clowrey/CellKeeper-BMS-PCB/enclosure/output/preview_kicad_bottom.png

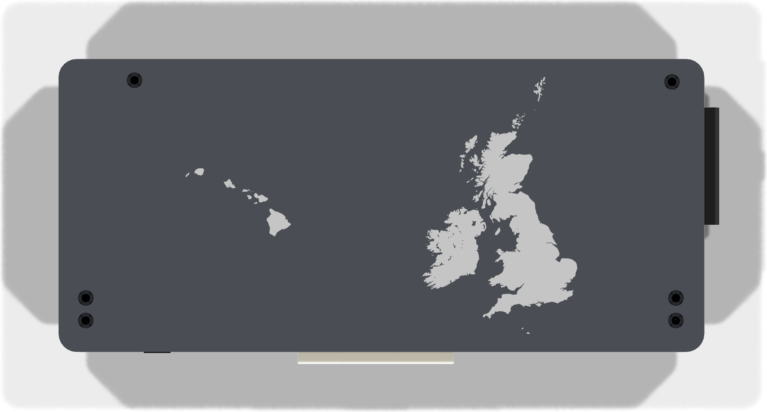
enclosure/output/preview_kicad_bottom.png
