clowrey/CellKeeper-BMS-PCB/enclosure/output/preview_kicad_top.png

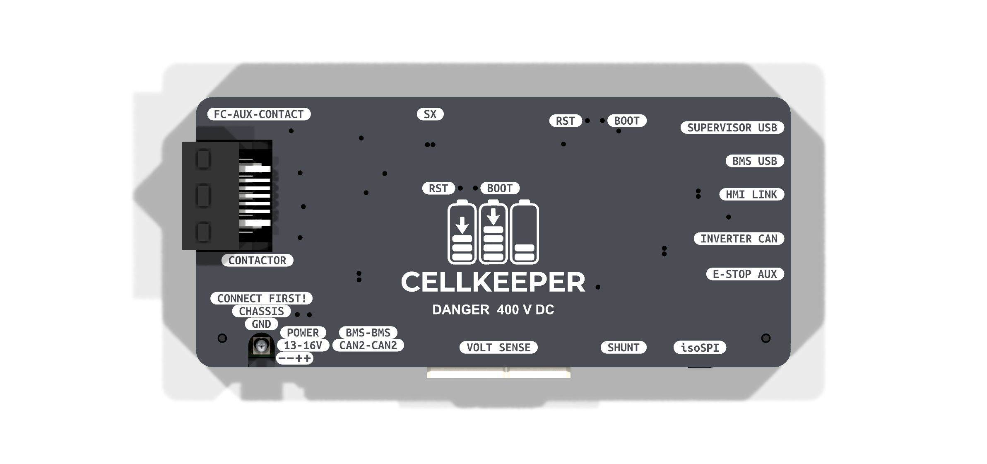
enclosure/output/preview_kicad_top.png
