clowrey/CellKeeper-BMS-PCB/enclosure/output/kicad/case_base.step

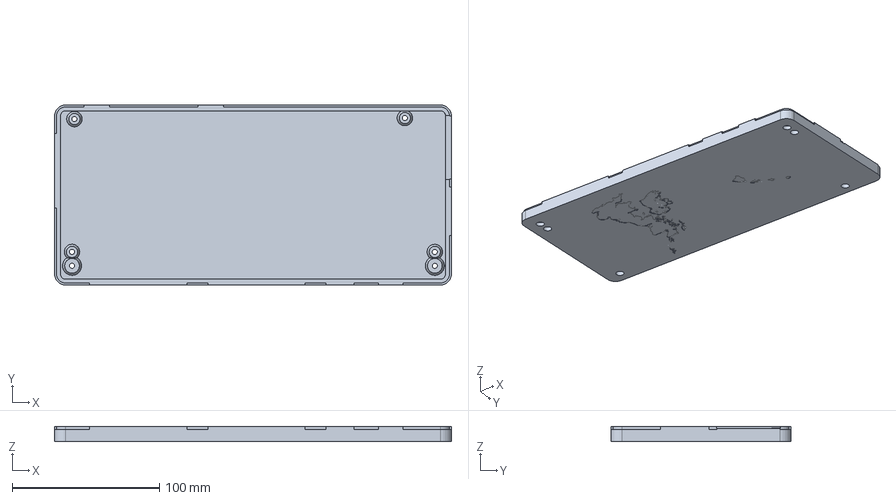
[picture p5: CAD file, 2026-10-24]
enclosure/output/kicad/case_base.step
269.2 x 122.2 x 10.0 mm
