clowrey/CellKeeper-BMS-PCB/enclosure/output/print/split/split_lid_right_2color_inlay.stl

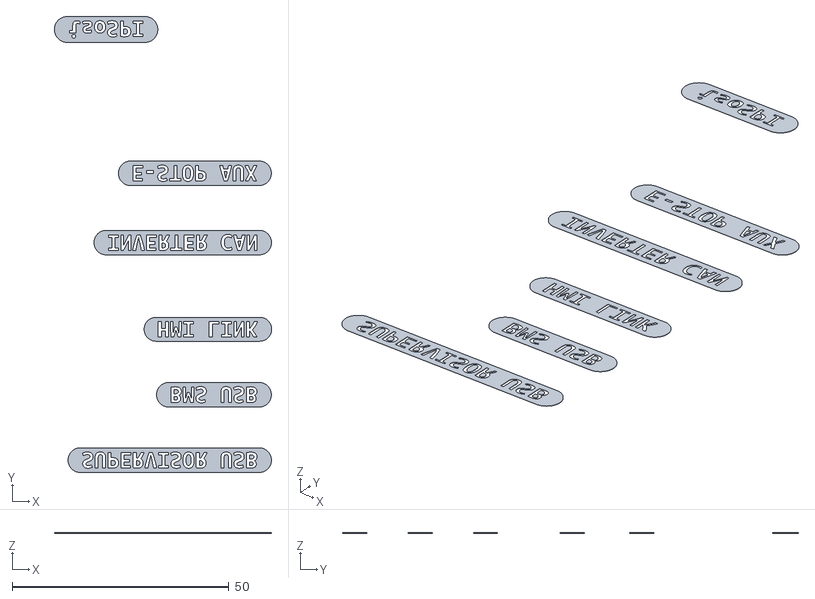
[picture p6: CAD file, 2026-10-24]
enclosure/output/print/split/split_lid_right_2color_inlay.stl
50.2 x 105.3 x 0.2
