clowrey/CellKeeper-BMS-PCB/enclosure/output/kicad/case_lid.step

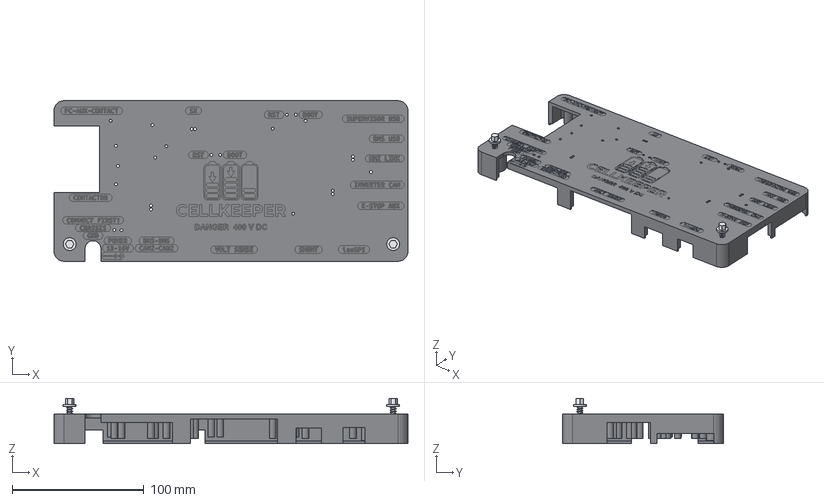
[picture p7: CAD file, 2026-10-24]
enclosure/output/kicad/case_lid.step
269.2 x 122.2 x 34.5 mm
case_lid
bracket_screw x 2
