clowrey/CellKeeper-BMS-PCB/enclosure/output/print/base.step

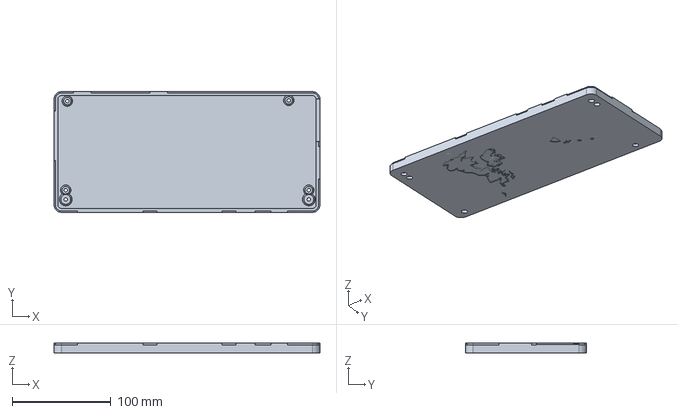
[picture p8: CAD file, 2026-10-24]
enclosure/output/print/base.step
269.2 x 122.2 x 10.0 mm
