clowrey/CellKeeper-BMS-PCB/enclosure/output/CellKeeper_board.step

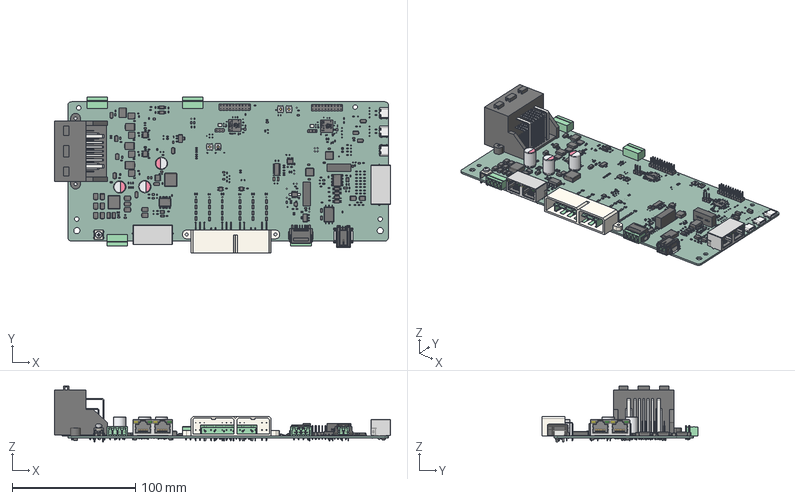
[picture p9: CAD file, 2026-10-21]
enclosure/output/CellKeeper_board.step
272.4 x 126.4 x 45.4 mm
D_SMB x 13
C_0603_1608Metric x 46
R_0603_1608Metric x 122
TSSOP-10_3x3mm_P0.5mm x 3
LED_0805_2012Metric x 21
R_1206_3216Metric x 28
C_0805_2012Metric x 18
R_0402_1005Metric x 24
PinHeader_1x03_P254mm_Vertical x 2
SOP-4_4.4x2.6mm_P1.27mm x 6
C_0402_1005Metric x 36
USB-C_SMD-TYPE-C-31-M-12 x 3
SOP-8_6.605x9.655mm_P2.54mm x 2
E5J88-44AHS4-LT x 2
D_SMA x 12
SOT-223 x 2
HTSOP_8_1EP_39x49mm_Pitch127mm
PinHeader_2x10_P254mm_Vertical x 2
L_Changjiang_FXL1040 x 2
a4dc038a-92ba-11ed-bd60-83025610b399_part x 4
a4dc038b-92ba-11ed-bd60-83025610b399_part x 4
a4dc038c-92ba-11ed-bd60-83025610b399_part x 4
a4dc038d-92ba-11ed-bd60-83025610b399_part x 4
SOIC-8_3.9x4.9mm_P1.27mm x 4
MC_01x04_G_3_81mm x 4
L_0603_1608Metric x 3
C_1206_3216Metric x 2
SOIC-16_3.9x9.9mm_P1.27mm
GMSTBA_01x06_G_7_62mm
Crystal_SMD_3225-4Pin_3.2x2.5mm x 2
D_SMC x 4
MC_01x02_G_3_81mm
L_Changjiang_FXL0630 x 2
MC_01x08_G_3_81mm
CellKeeper_PCB
