clowrey/CellKeeper-BMS-PCB/enclosure/output/kicad/case_inlay.step

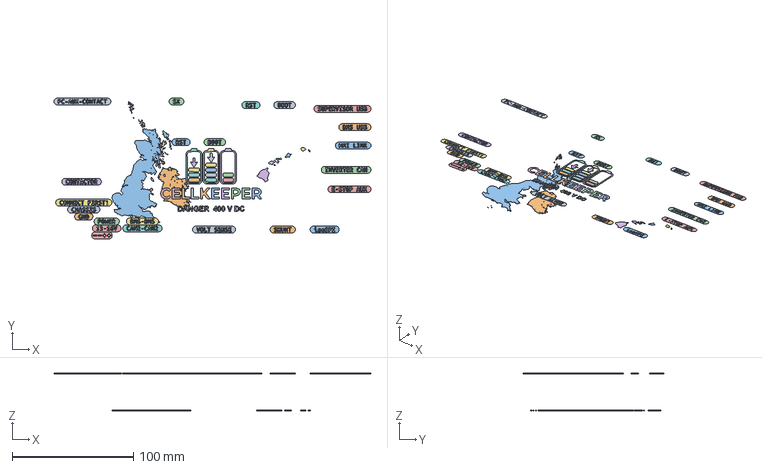
[picture p10: CAD file, 2026-10-24]
enclosure/output/kicad/case_inlay.step
261.1 x 116.1 x 30.6 mm
