clowrey/CellKeeper-BMS-PCB/enclosure/output/print/lid_2color.step

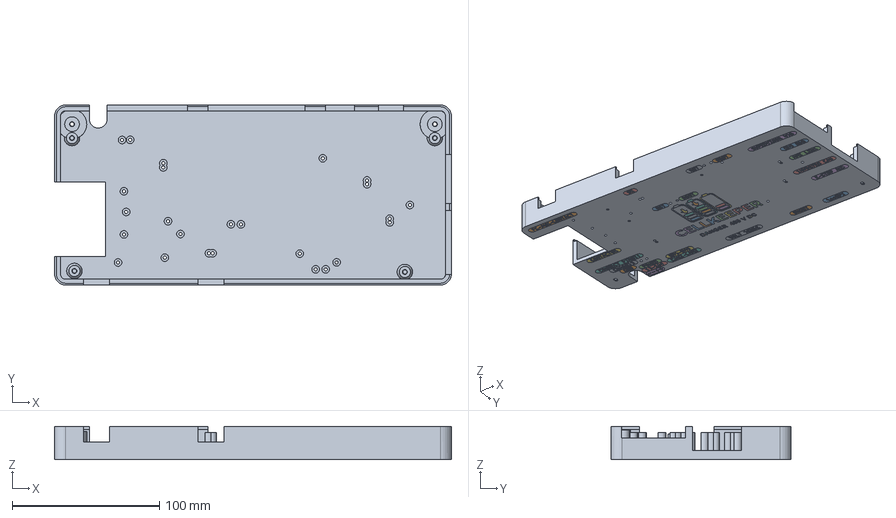
[picture p11: CAD file, 2026-10-24]
enclosure/output/print/lid_2color.step
269.2 x 122.2 x 22.4 mm
case
inlay
