clowrey/CellKeeper-BMS-PCB/enclosure/output/print/split/split_base_right_2color.step

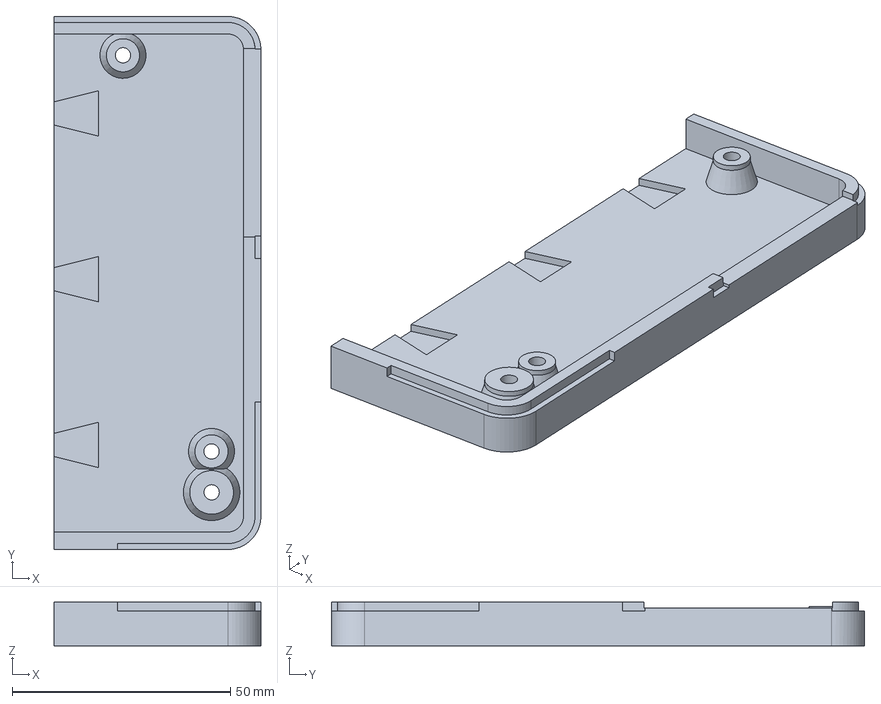
[picture p12: CAD file, 2026-10-24]
enclosure/output/print/split/split_base_right_2color.step
47.4 x 122.2 x 10.0 mm
