clowrey/CellKeeper-BMS-PCB/enclosure/output/enclosure_bambu.3mf

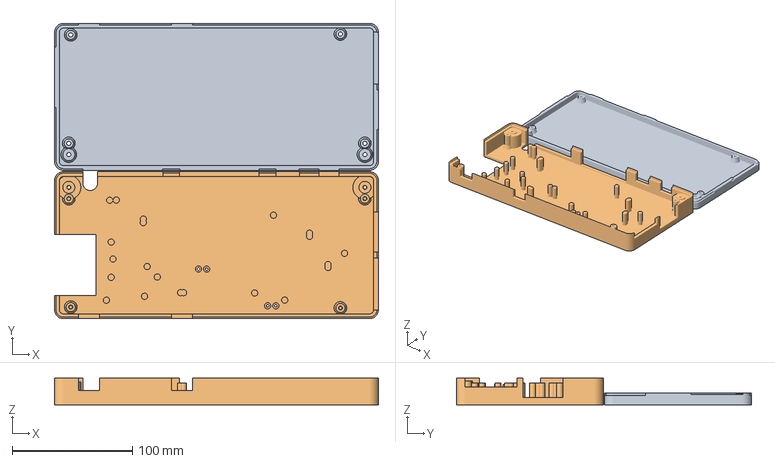
[picture p13: CAD file, 2026-10-21]
enclosure/output/enclosure_bambu.3mf
269.2 x 245.4 x 22.4 mm
base.step
lid_2color.step
