clowrey/CellKeeper-BMS-PCB/enclosure/output/print/lid.step

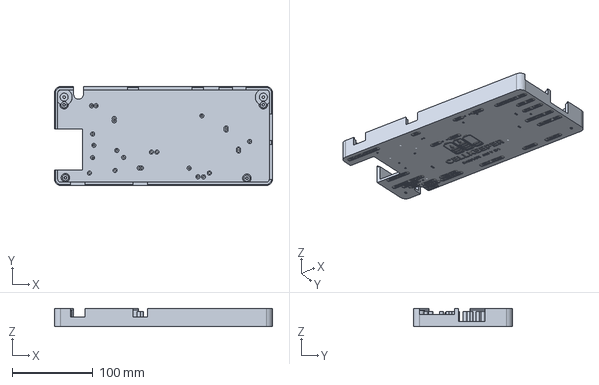
[picture p15: CAD file, 2026-10-24]
enclosure/output/print/lid.step
269.2 x 122.2 x 22.4 mm
