clowrey/CellKeeper-BMS-PCB/enclosure/output/print/split/split_lid_left_2color_inlay.stl

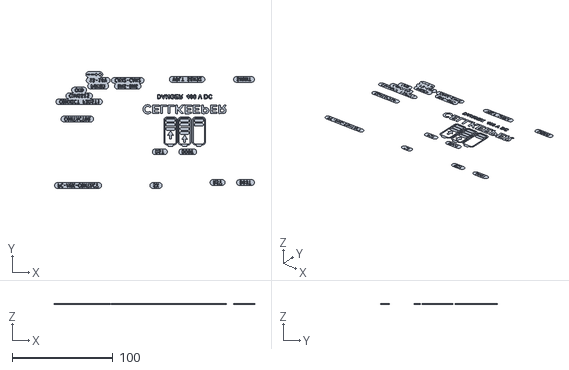
[picture p16: CAD file, 2026-10-24]
enclosure/output/print/split/split_lid_left_2color_inlay.stl
198.9 x 116.1 x 0.2
