clowrey/CellKeeper-BMS-PCB/enclosure/output/print/split/split_key_x6.step

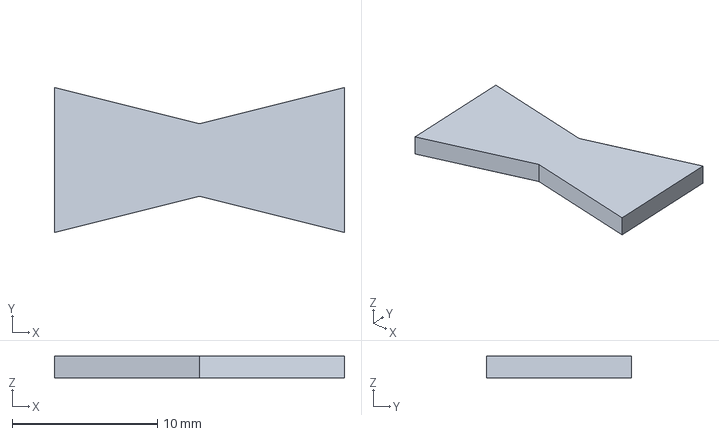
[picture p17: CAD file, 2026-10-24]
enclosure/output/print/split/split_key_x6.step
20.0 x 10.0 x 1.50 mm
