clowrey/CellKeeper-BMS-PCB/enclosure/output/print/split_lid_right.step

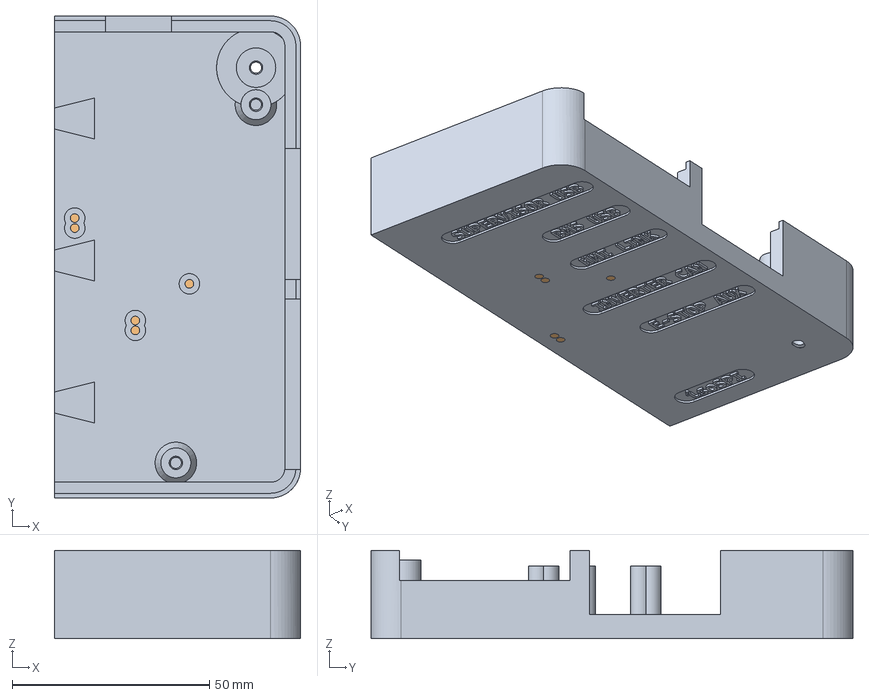
[picture p18: CAD file, 2026-10-23]
enclosure/output/print/split_lid_right.step
62.4 x 122.2 x 22.4 mm
case
light_windows
