clowrey/CellKeeper-BMS-PCB/enclosure/output/print/split/split_lid_left_2color.step

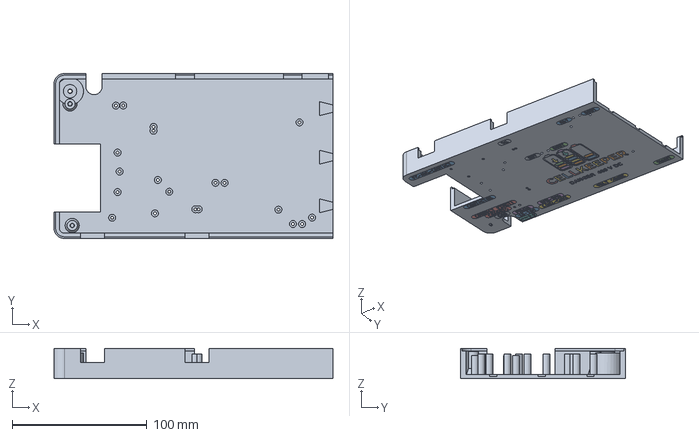
[picture p19: CAD file, 2026-10-24]
enclosure/output/print/split/split_lid_left_2color.step
206.8 x 122.2 x 22.4 mm
case
inlay
