clowrey/CellKeeper-BMS-PCB/enclosure/output/print/split/split_lid_right_2color.step

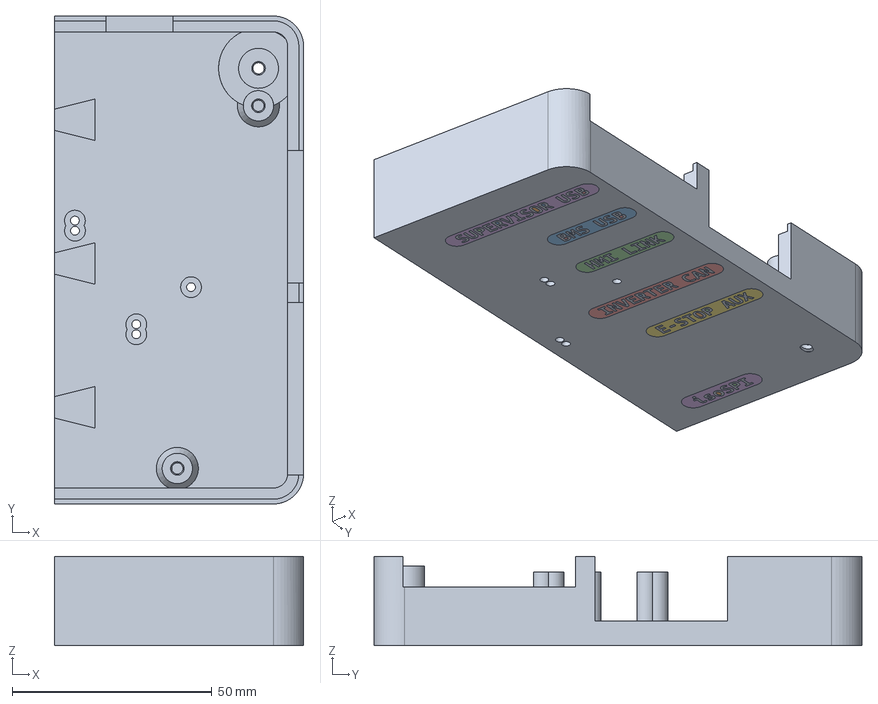
[picture p20: CAD file, 2026-10-24]
enclosure/output/print/split/split_lid_right_2color.step
62.4 x 122.2 x 22.4 mm
case
inlay
