clowrey/CellKeeper-BMS-PCB/enclosure/output/print/split/split_base_left.step

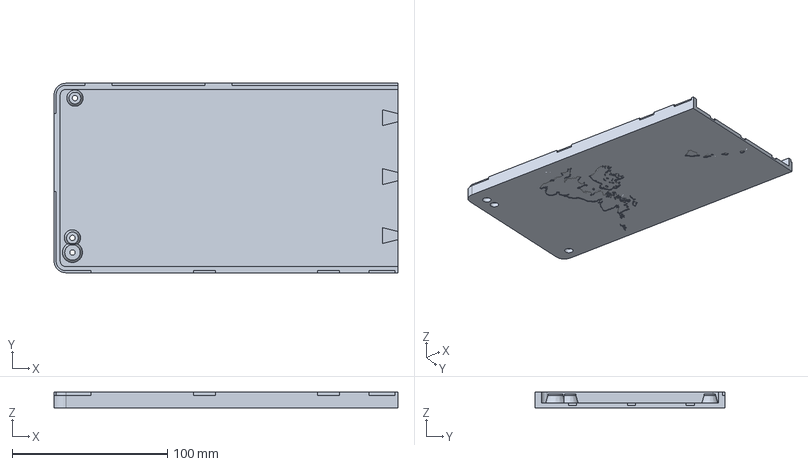
[picture p21: CAD file, 2026-10-24]
enclosure/output/print/split/split_base_left.step
221.8 x 122.2 x 10.0 mm
