clowrey/CellKeeper-BMS-PCB/(list of files, cad)

Other CAD files:
enclosure/output/cellkeeper_case_assembly.step
enclosure/output/print/base_2color_inlay.stl
enclosure/output/print/split/split_base_left_2color_inlay.stl
enclosure/output/print/base_2color.step
enclosure/output/print/split_lid_left_open.step
enclosure/output/print/split/split_base_right.step
enclosure/output/print/split_lid_left.step
enclosure/output/print/split/split_base_left_2color.step
enclosure/output/print/split_lid_right_open.step
enclosure/output/print/split/split_lid_right.step
enclosure/output/print/split_key_x6.step
enclosure/output/bracket_screw.step
enclosure/output/print/base.stl
enclosure/output/print/base_2color.stl
enclosure/output/print/split/split_base_left.stl
enclosure/output/print/split/split_base_left_2color.stl
enclosure/output/print/split/split_base_right.stl
enclosure/output/print/split/split_base_right_2color.stl
enclosure/output/print/split/split_key_x6.stl
enclosure/output/print/split/split_lid_left.stl
enclosure/output/print/split/split_lid_left_2color.stl
enclosure/output/print/split/split_lid_right.stl
enclosure/output/print/split/split_lid_right_2color.stl
