clowrey/CellKeeper-BMS-PCB/CellKeeper/CellKeeper.kicad_pcb

## KiCad design CellKeeper/CellKeeper.kicad_pcb (2026-10-21)

Schematic: CellKeeper.kicad_sch

Parts:
1/2V1, 3v1, 5V1: TP; BMS_Library__TestPoint_THTPad_D1.5mm_Drill1.0mm
BT5, BT6, BT7, BT8: ~100V Brick
C1, C14, C31: 680uF; Capacitor_THT__CP_Radial_D10.0mm_P5.00mm; Voltage 35V Polymer; JLCPCB Part # C46550429
C2, C10, C11, C13, C15, C16, C18, C22, C23, C28, C29, C30, C34, C35, C36, C54, C60, C73, C74, C89, C91, C104: 100nF; Capacitor_SMD__C_0603_1608Metric; JLCPCB Part # C14663
C3, C4, C6, C8, C17, C32, C66: 10uF; Capacitor_SMD__C_0805_2012Metric; Voltage 50V; JLCPCB Part # C440198
C5, C7, C12, C33, C37, C48, C49, C69: 22uF; Capacitor_SMD__C_0805_2012Metric; Voltage 25V X5R; JLCPCB Part # C45783
C9: 4.7uF; Capacitor_SMD__C_0603_1608Metric; JLCPCB Part # C19666
C19, C20, C41, C42, C67, C96, C97, C98, C99: 1uF; Capacitor_SMD__C_0603_1608Metric; JLCPCB Part # C15849
C21, C55, C116: 10uF; Capacitor_SMD__C_0805_2012Metric; Voltage 50V X5R; JLCPCB Part # C440198
C24, C25, C26, C27, C103: 100pF; Capacitor_SMD__C_0603_1608Metric; JLCPCB Part # C14858
C38, C43, C45, C52, C68, C72, C82, C87: 4.7u; RP2350_80QFN_minimal__C_0402_1005Metric_small_pads; JLCPCB Part # C23733
C39, C40, C70, C71: 15pF; Capacitor_SMD__C_0402_1005Metric; JLCPCB Part # C1548
C44, C46, C47, C50, C51, C53, C56, C58, C59, C61, C63, C65, C75, C83, C84, C85, C86, C88, C90, C92, C93, C100, C101, C102: 100n; Capacitor_SMD__C_0402_1005Metric; JLCPCB Part # C1525
C62, C64, C76, C77, C78, C79, C80, C81: 100nf; Capacitor_SMD__C_0603_1608Metric; JLCPCB Part # C14663
C94, C95: 1nF; Capacitor_SMD__C_1206_3216Metric; JLCPCB Part # C9196
Cell1, Cell2, Cell3: Battery_Cell
D1, D2, D3, D4, D5, D6, D24, D25, D26, D28, D29, D30, D31: SMB6.8CA; Diode_SMD__D_SMB; JLCPCB Part # C78395
D7, D8, D14, D19, D32, D35, D36, D43, D48: Green; LED_SMD__LED_0805_2012Metric; JLCPCB Part # C2297
D9, D10, D27, D41, D46, D49: Red; LED_SMD__LED_0805_2012Metric; JLCPCB Part # C84256
D11, D12, D15, D16, D20, D23, D37, D38, D42, D44, D47, D50: SS54; Diode_SMD__D_SMA; JLCPCB Part # C22452
D13, D17, D22, D33, D34, D45: White; LED_SMD__LED_0805_2012Metric; JLCPCB Part # C34499
D18, D21, D39, D40: SMCJ33CA; Diode_SMD__D_SMC; JLCPCB Part # C224050
F3: Pyro Fuse
F4: 63A HV DC
FB1, FB3, FB5: 600R@100MHz; Inductor_SMD__L_0603_1608Metric_Pad1.05x0.95mm_HandSolder; JLCPCB Part # C1002
FB2: 120Ω@100MHz; Capacitor_SMD__C_0603_1608Metric; JLCPCB Part # C14709
FL1, FL2: SDCW3225S-2-102TF; BMS_Library__FILTER-SMD_4P-L3.2-W2.5-BL; JLCPCB Part # C192586
GND1: TP; BMS_Library__TestPoint_THTPad_D1.5mm_Drill1.0mm
GPIO44, GPIO45, GPIO46: TP; BMS_Library__TestPoint_THTPad_D1.5mm_Drill1.0mm
H1, H2, H7, H8: MountingHole_Pad; MountingHole__MountingHole_3.7mm; not fitted
H3, H4: MountingHole_Pad; MountingHole__MountingHole_5mm; not fitted
H5, H6: MountingHole_Pad
J1: WJ15EDGRC-3.81-04P-14-00A; BMS_Library__PhoenixContact_MC_1_5_4-G-3.81_1x04_P3.81mm_Ho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; JLCPCB Part # C7245
J2: T34008; BMS_Library__XFCN_T34008_M3_Terminal_Frame_PCB; JLCPCB Part # C481446
J3, J7: Screw_Terminal_01x04; BMS_Library__PhoenixContact_MC_1_5_4-G-3.81_1x04_P3.81mm_Ho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; JLCPCB Part # C7245; not fitted
J4, J5: 8P8C_LED_Shielded_x2; Connector_RJ__RJ45_HCTL_HC-RJ45-5JA-2-2-Y; JLCPCB Part # C3010546
J6: S44B-RAD1AK; BMS_Library__S44BRAD1AK; Mfr. # S44B-RAD1AK
J8, J16: Conn_01x03; Connector_PinHeader_2.54mm__PinHeader_1x03_P2.54mm_Vertical; not fitted
J9, J11, J19: USB_C_Receptacle_USB2.0_16P; BMS_Library__USB_C_Receptacle_HRO_TYPE-C-31-M-12; JLCPCB Part # C2765186
J10: 3.81P Screw Terminal; BMS_Library__PhoenixContact_MC_1_5_8-G-3.81_1x08_P3.81mm_Ho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; not fitted
J12, J22: Conn_02x10_Odd_Even; Connector_PinHeader_2.54mm__PinHeader_2x10_P2.54mm_Vertical; not fitted
J14: ZE05H-8DP-2H; BMS_Library__CONN_ZE05H-8DP-2H_HIR; MFR.Part # ZE05H-8DP-2H; JLCPCB Part # C17284895
J15: WJ15EDGRC-3.81-04P-14-00A; BMS_Library__PhoenixContact_MC_1_5_4-G-3.81_1x04_P3.81mm_Ho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; JLCPCB Part # C7245; not fitted
J17: OEM HV Sense Connector; BMS_Library__CONN_173864-1_TYC_Empty_Pins; MFR Part # 173864-1; JLCPCB Part # C573648
J18: 7.62mm Pitch Screw Terminal; Connector_Phoenix_GMSTB__PhoenixContact_GMSTBA_2_5_6-G-7_62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; not fitted
J20: OEM Connector; BMS_Library__CONN_SD-34912-001_02_MOL; MFR.Part # 349128020; JLCPCB Part # C587318
J21: 3.81P Screw Terminal; BMS_Library__PhoenixContact_MC_1_5_2-G-3.81_1x02_P3.81mm_Ho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; not fitted
JP1, JP2, JP3, JP4, JP7, JP8, JP9, JP12, JP13, JP14, JP16, JP17, JP18, JP19, JP20, JP21, JP22, JP23, JP24, JP27, JP28, JP29, JP30, JP31, JP32, JP33, JP34, JP35, JP37: 0r; BMS_Library__J_0603_jumper; JLCPCB Part # C21189; not fitted
JP5, JP6, JP10, JP11, JP15, JP36: 0r; BMS_Library__J_0603_jumper; JLCPCB Part # C21189
JP25, JP26: jumper-bridged; Jumper__SolderJumper-2_P1.3mm_Bridged_RoundedPad1.0x1.5mm
K5: Link Positive
K6: Link Negative
K7: FC Negative
K8: FC Positive
L1, L5: 6.8uh; Inductor_SMD__L_Changjiang_FXL0630; JLCPCB Part # C167221
L2, L3: 22uh 5.5A; Inductor_SMD__L_Changjiang_FXL1040; JLCPCB Part # C475917
L4, L6: 3.3uh; RP2350_80QFN_minimal__L_pol_2016; JLCPCB Part # C42411119
L7: Inverter
Q1, Q2, Q3, Q4: BSC0805LS; BMS_Library__TDSON-8_5x6_; JLCPCB Part # C534374
R1, R2, R11, R16, R29, R33, R35, R39, R40, R41, R96, R97, R98, R99, R100, R101, R140: 24k; Resistor_SMD__R_0603_1608Metric; JLCPCB Part # C23352
R3, R4, R13, R14, R15, R17, R19, R20, R21, R25, R28, R42, R50, R51, R52, R75, R84: 10k; Resistor_SMD__R_0603_1608Metric; JLCPCB Part # C25804
R5, R10, R18, R24, R34, R36, R151, R152: 100k; Resistor_SMD__R_0603_1608Metric; JLCPCB Part # C25803
R6: 25296nΩ
R7, R12, R37, R38: 33R; Resistor_SMD__R_0603_1608Metric; JLCPCB Part # C23140
R8, R9, R22, R23, R46, R47, R48, R49, R76, R133, R134, R141: 1k; Resistor_SMD__R_0603_1608Metric; JLCPCB Part # C21190
R26, R78, R155: 3.3k; Resistor_SMD__R_0402_1005Metric; JLCPCB Part # C25890
R27, R53, R55, R56, R74, R92, R94, R95, R129, R130, R131, R132, R135: 1k; Resistor_SMD__R_0402_1005Metric; JLCPCB Part # C11702
R30, R73: 510r; Resistor_SMD__R_0603_1608Metric; JLCPCB Part # C23193
R31, R32: 120r; Resistor_SMD__R_1206_3216Metric; JLCPCB Part # C17909
R43, R44: 2.2k; Resistor_SMD__R_0603_1608Metric; JLCPCB Part # C4190
R45, R57, R66, R69, R72, R77, R79, R80, R81, R82, R83, R85, R89, R90, R138, R139, R143, R144, R153, R154: 5.1k; Resistor_SMD__R_0603_1608Metric; JLCPCB Part # C23186
R54, R68, R93, R126: 33r; Resistor_SMD__R_0402_1005Metric; JLCPCB Part # C25105
R58, R59, R60, R61, R62, R63, R64, R65: 18r
R67: 12.24R
R70, R71, R127, R128: 22R; Resistor_SMD__R_0402_1005Metric; JLCPCB Part # C25092
R87, R88: 220r; Resistor_SMD__R_0603_1608Metric; JLCPCB Part # C22962
R102, R103, R104, R105, R106, R107, R108, R109, R110, R111, R112, R113, R114, R115, R116, R117, R118, R119, R120, R121, R122, R123, R124, R125: 3M; Resistor_SMD__R_1206_3216Metric; JLCPCB Part # C488822
R136, R137: 47r; Resistor_SMD__R_0603_1608Metric; JLCPCB Part # C23182
R142: 100R; Resistor_SMD__R_0603_1608Metric; JLCPCB Part # C22775
R145, R146: 1M; Resistor_SMD__R_1206_3216Metric; JLCPCB Part # C17927
RevisionS1: TP; BMS_Library__TestPoint_THTPad_D1.5mm_Drill1.0mm
SW1, SW2, SW3, SW4: TS-1187A-B-A-B; Button_Switch_SMD__SW_Push_1P1T_XKB_TS-1187A; JLCPCB Part # C318884
TH1, TH2, TH3, TH4, TH5, TH6: B59451C1130B070; JLCPCB Part # C2762811
TP1, TP2, TP4, TP6, TP7, TP8, TP9, TP10, TP15, TP23, TP24, TP25, TP34, TP35, TP36, TP37, TP43, TP44: TestPoint_2Pole; BMS_Library__TestPoint_2Pads_Pitch2.54mm_Pad1.5_Drill1.0mm
TP3, TP5, TP11, TP12, TP13, TP14, TP16, TP17, TP18, TP19, TP20, TP21, TP22, TP26, TP27, TP28, TP29, TP30, TP31, TP32, TP33, TP38, TP39, TP40, TP41, TP49: TP; BMS_Library__TestPoint_THTPad_D1.5mm_Drill1.0mm
TP42: TestPoint_2Pole; BMS_Library__TestPoint_2Pads_Pitch2.54mm_Pad1.5_Drill1.0mm; not fitted
TR1: HM2113ZNLT; BMS_Library__HM2113ZNLT; JLCPCB Part # C5730533
U1, U11: UCC27524DR; Package_SO__SOIC-8_3.9x4.9mm_P1.27mm; JLCPCB Part # C465729
U3: TPS5430DDAR; Package_SO__TI_SO-PowerPAD-8_ThermalVias; LCSC Part C9864
U4, U15: F0505S-1WR3; BMS_Library__H0505S-1WR2; JLCPCB Part # C7465182
U5, U10: ISO1050DUB; Package_SO__SOP-8_6.62x9.15mm_P2.54mm; LCSC Part # C16428
U6, U7, U8, U9, U12, U13: LTV-217-B-G; Package_SO__SSOP-4_4.4x2.6mm_P1.27mm; JLCPCB Part # C115450
U14, U20: RP2354B; RP2350_80QFN_minimal__RP2350-QFN-80-1EP_10x10_P0.4mm_EP3.4x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; JLCPCB Part # C39843328
U16: ISO1540; Package_SO__SOIC-8_3.9x4.9mm_P1.27mm; JLCPCB Part # C179739
U17: INA228; Package_SO__TSSOP-10_3x3mm_P0.5mm; JLCPCB Part # C5214669
U18, U19: ADS1115; Package_SO__TSSOP-10_3x3mm_P0.5mm; LCSC Part # C37593
U21: SP3485EN-L/TR; Package_SO__SOIC-8_3.9x4.9mm_P1.27mm; JLCPCB Part # C8963
U22: AM26LV32EIDR; Package_SO__SOIC-16_3.9x9.9mm_P1.27mm; JLCPCB Part # C527448
U25, U26: TLV1117LV33DCYR; Package_TO_SOT_SMD__SOT-223-3_TabPin2; JLCPCB Part # C15578
Y1, Y2: ABM8-272-T3; Crystal__Crystal_SMD_3225-4Pin_3.2x2.5mm; JLCPCB Part # C20625731

Connections:
3.3V Sense: C22.2, R20.2, R21.1, U14.49 (GPIO40_ADC0)
5V Sense: C36.2, R41.2, R42.1, U14.52 (GPIO41_ADC1)
+1V1: C43.1, C44.1, C46.1, C47.1, L4.1, U14.10 (DVDD), U14.32 (DVDD), U14.51 (DVDD), U14.65 (VREG_FB)
+1V1_2: C72.1, C75.1, C83.1, C84.1, L6.1, U20.10 (DVDD), U20.32 (DVDD), U20.51 (DVDD), U20.65 (VREG_FB)
+3.3V: C9.2, C10.1, C11.1, C38.1, C50.1, C51.1, C53.1, C56.1, C58.1, C59.1, C61.1, C63.1, C65.1, C66.2, C68.1, C85.1, C86.1, C88.1, C89.1, C90.1, C91.2, C92.1, C93.1, C100.1, C101.1, C102.1, D7.2 (A), D9.2 (A), D41.2 (A), D43.2 (A), FB5.1, J3.1, J12.5, J12.7, J12.9, J22.5, J22.7, J22.9, JP35.2, R2.1, R4.1, R15.1, R20.1, R28.1, R29.1, R54.2, R57.1, R66.1, R68.2, R75.1, R89.1, R90.1, R93.2, R126.2, R135.1, TP4.2, U5.1 (VCC1), U6.4, U7.4, U10.1 (VCC1), U12.4, U13.4, U14.5 (IOVDD), U14.15 (IOVDD), U14.24 (IOVDD), U14.29 (IOVDD), U14.41 (IOVDD), U14.50 (IOVDD), U14.60 (IOVDD), U14.64 (VREG_VIN), U14.68 (USB_OTP_VDD), U14.69 (QSPI_IOVDD), U14.76 (IOVDD), U16.1 (VCC1), U20.5 (IOVDD), U20.15 (IOVDD), U20.24 (IOVDD), U20.29 (IOVDD), U20.41 (IOVDD), U20.50 (IOVDD), U20.60 (IOVDD), U20.64 (VREG_VIN), U20.68 (USB_OTP_VDD), U20.69 (QSPI_IOVDD), U20.76 (IOVDD), U21.8 (VCC), U22.4 (G), U22.16 (VDD), U25.2 (VO)
+3.3VSen: 3v1.1 (1_1), C67.2, C73.2, C74.2, FB5.2, R87.1, U18.8 (VDD), U19.1 (ADDR), U19.8 (VDD)
+5V: C2.2, C3.2, C7.2, C18.2, C29.2, C31.1, C32.2, C33.2, C37.2, C41.2, C42.2, C48.2, D50.2 (A), FB2.2, J12.1, J12.3, J22.1, J22.3, L1.2, L3.1, L5.2, R26.1, R35.1, R41.1, TP9.2, U1.6 (V_{DD}), U10.8 (VCC2), U11.6 (V_{DD}), U12.1, U13.1
+LDO_IN: C5.2, D44.1 (K), D47.1 (K), D50.1 (K), U25.3 (VI)
/Blue: J4.4, JP15.2, JP16.1, JP18.1
/Brown: J4.8, JP19.2, JP20.1, JP23.1
/CAN2 H: C26.2, D30.2 (A2), FL2.2, J5.4, J5.16, R32.2, TP8.2
/CAN2 L: C27.1, D31.1 (A1), FL2.3, J5.5, J5.17, JP5.1, TP8.1
/CAN 5V: 5V1.1 (1_1), C28.2, FB1.2, R22.2, R30.1, R33.1, R43.2, U5.8 (VCC2)
/CAN H: C24.2, D28.2 (A2), FL1.2, JP3.1, JP7.1, JP9.1, JP13.1, JP15.1, JP19.1, JP21.1, JP27.1, JP36.1, TP7.2
/CAN L: C25.1, D29.1 (A1), FL1.3, JP4.2, JP8.2, JP10.2, JP14.2, JP16.2, JP20.2, JP22.2, JP28.2, R31.1, TP7.1
/Contactor_Input: D1.2 (A2), D11.2 (A), D12.2 (A), J1.3
/FC-CTR-NEG-AUX-D: J6.17, J7.2, R47.1
/FC-CTR-POS-AUX-D: J6.18, J7.1, R46.1
/FC-Neg-Jumper: C35.2, D36.1 (K), D38.2 (A), D40.2 (A2), JP25.1 (A), JP26.1 (A), Q4.5 (D)
/FC-Pos-Jumper: C13.2, D14.1 (K), D16.2 (A), D18.2 (A2), JP1.1, JP2.1, Q1.5 (D)
/GPIO0: R74.2, U14.77 (GPIO0)
/GPIO25: R85.1, U14.26 (GPIO25)
/GPIO44_ADC4: GPIO44.1 (1_1), U14.55 (GPIO44_ADC4)
/GPIO45_ADC5: GPIO45.1 (1_1), U14.56 (GPIO45_ADC5)
/GPIO46_ADC6: GPIO46.1 (1_1), U14.57 (GPIO46_ADC6)
/GPIO47_ADC7: R75.2, R76.1, RevisionS1.1 (1_1), U14.58 (GPIO47_ADC7)
/Grn: J4.6, JP7.2, JP8.1, JP11.1
/Logic_Input: D4.2 (A2), D15.2 (A), J1.4, R151.2
/MCU2_GPIO0: R135.2, U20.77 (GPIO0)
/MCU2_GPIO1: R131.2, U20.78 (GPIO1)
/MCU2_GPIO2: R132.2, U20.79 (GPIO2)
/MCU2_GPIO4: J22.4, U20.1 (GPIO4)
/MCU2_GPIO5: J22.6, U20.2 (GPIO5)
/MCU2_GPIO6: J22.8, R133.1, U20.3 (GPIO6)
/MCU2_GPIO7: J22.10, U20.4 (GPIO7)
/MCU2_GPIO8: J22.12, R134.1, U20.6 (GPIO8)
/MCU2_GPIO9: J22.14, U20.7 (GPIO9)
/MCU2_GPIO10: J22.16, U20.8 (GPIO10)
/MCU2_GPIO12: J22.20, U20.11 (GPIO12)
/MCU2_GPIO13: U20.12 (GPIO13)
/MCU2_GPIO14: R140.1, R141.1, U20.13 (GPIO14)
/MCU2_GPIO15: U20.14 (GPIO15)
/MCU2_GPIO16: U20.16 (GPIO16)
/MCU2_GPIO17: U20.17 (GPIO17)
/MCU2_GPIO18: U20.18 (GPIO18)
/MCU2_GPIO19: U20.19 (GPIO19)
/MCU2_GPIO20: U20.20 (GPIO20)
/MCU2_GPIO21: U20.21 (GPIO21)
/MCU2_GPIO22: U20.22 (GPIO22)
/MCU2_GPIO23: U20.23 (GPIO23)
/MCU2_GPIO24: U20.25 (GPIO24)
/MCU2_GPIO25: R143.1, U20.26 (GPIO25)
/MCU2_GPIO26: U20.27 (GPIO26)
/MCU2_GPIO27: U20.28 (GPIO27)
/MCU2_GPIO33: U20.42 (GPIO33)
/MCU2_GPIO34: U20.43 (GPIO34)
/MCU2_GPIO35: U20.44 (GPIO35)
/MCU2_GPIO36: U20.45 (GPIO36)
/MCU2_GPIO37: U20.46 (GPIO37)
/MCU2_GPIO38: R129.2, U20.47 (GPIO38)
/MCU2_GPIO39: R130.2, U20.48 (GPIO39)
/Orange: J4.2, JP21.2, JP22.1, JP24.1
/PH: C16.1, D23.1 (K), L3.2, U3.8 (PH)
/QSPI2_SCLK: U20.71 (QSPI_SCLK)
/QSPI2_SD0: U20.72 (QSPI_SD0)
/QSPI2_SD1: U20.74 (QSPI_SD1)
/QSPI2_SD2: U20.73 (QSPI_SD2)
/QSPI2_SD3: U20.70 (QSPI_SD3)
/QSPI2_SS: R94.1, U20.75 (QSPI_SS)
/QSPI_SCLK: U14.71 (QSPI_SCLK)
/QSPI_SD0: U14.72 (QSPI_SD0)
/QSPI_SD1: U14.74 (QSPI_SD1)
/QSPI_SD2: U14.73 (QSPI_SD2)
/QSPI_SD3: U14.70 (QSPI_SD3)
/QSPI_SS: R55.1, U14.75 (QSPI_SS)
/RUN: R56.2, SW2.2, TP14.1 (1_1)
/RUN_2: R95.1, U20.35 (RUN)
/SWCLK: J8.1, U14.33 (SWCLK)
/SWCLK_2: J16.1, U20.33 (SWCLK)
/SWD: J8.3, U14.34 (SWD)
/SWD_2: J16.3, U20.34 (SWD)
/Serial API 5V Diode: D42.1 (K), J9.A4 (VBUS), J9.A9 (VBUS), J9.B4 (VBUS), J9.B9 (VBUS), TP13.1 (1_1)
/Serial API RX: J9.A7 (D-), J9.B7 (D-), R48.1, R50.2, TP10.1
/Serial API TX: J9.A6 (D+), J9.B6 (D+), R49.1, TP10.2
/USB2_D+: J19.A6 (D+), J19.B6 (D+), R127.1, TP39.1 (1_1)
/USB2_D-: J19.A7 (D-), J19.B7 (D-), R128.1, TP40.1 (1_1)
/USB_D+: J11.A6 (D+), J11.B6 (D+), R70.1, TP20.1 (1_1)
/USB_D-: J11.A7 (D-), J11.B7 (D-), R71.1, TP21.1 (1_1)
/VREG2_AVDD: C82.1, R93.1, U20.61 (VREG_AVDD)
/VREG2_LX: L6.2, U20.63 (VREG_LX)
/VREG_AVDD: C45.1, R54.1, U14.61 (VREG_AVDD)
/VREG_LX: L4.2, U14.63 (VREG_LX)
/V_cont1: C8.2, D11.1 (K), D12.1 (K), L2.2
/Wht-Blue: J4.5, JP9.2, JP10.1, JP12.1
/Wht-Brown: J4.7, JP13.2, JP14.1, JP17.1
/Wht-Grn: J4.3, JP3.2, JP4.1, JP6.1
/Wht-Org: J4.1, JP27.2, JP28.1, JP29.1
/XIN: C39.1, U14.30 (XIN), Y1.1
/XIN_2: C70.1, U20.30 (XIN), Y2.1
/XOUT: R53.1, U14.31 (XOUT)
/XOUT_2: R92.1, U20.31 (XOUT)
/iso+: C96.1, C99.1, C103.2, R136.2, R142.1, TP42.1, TR1.1 (TD-)
/iso-: C97.1, C98.1, C103.1, R137.2, R142.2, TP42.2, TR1.3 (TD+)
Batt Negative: J17.1, J18.6, R121.2
Batt Positive: J17.10, J18.1, R120.2
C FC-Neg (GND): J6.37, J10.2, JP25.2 (B), JP26.2 (B)
C FC-Pos (GND): J6.36, J10.4, JP1.2, JP2.2
C Neg (GND): C34.2, D35.1 (K), D37.2 (A), D39.2 (A2), J6.42, J10.6, Q3.5 (D)
C Pos (GND): C15.2, D19.1 (K), D20.2 (A), D21.2 (A2), J6.41, J10.8, Q2.5 (D)
CAN2 Rx: D8.1 (K), J12.6, TP2.1, U10.2 (RXD), U14.2 (GPIO5)
CAN2 Tx: D10.1 (K), J12.4, TP2.2, U10.3 (TXD), U14.1 (GPIO4)
CAN Rx: R1.2, TP1.1, U5.2 (RXD), U14.20 (GPIO20)
CAN Tx: R3.2, TP1.2, U5.3 (TXD), U14.19 (GPIO19)
CTR-FC-NEG: R83.1, U11.4 (INB), U14.14 (GPIO15)
CTR-FC-Pos: R82.1, U1.4 (INB), U14.16 (GPIO16)
CTR-LNK-NEG: R81.1, U11.2 (INA), U14.17 (GPIO17)
CTR-LNK-POS: R77.1, U1.2 (INA), U14.18 (GPIO18)
CTR_EN: R141.2, R144.1, U1.1 (ENA), U1.8 (ENB), U11.1 (ENA), U11.8 (ENB)
Emergency Stop: J12.18, J22.18, R13.2, U6.3, U14.9 (GPIO11), U20.9 (GPIO11)
Extra Input: J12.20, R14.2, U7.3, U14.11 (GPIO12)
Extra Output 1: R8.1, U14.12 (GPIO13)
Extra Output 2: R9.1, U14.13 (GPIO14)
FC Negative: J17.4, J18.4, R123.2
FC Positive: J17.7, J18.3, R122.2
FC-CTR-NEG-AUX: J12.16, R52.2, U13.3, U14.8 (GPIO10)
FC-CTR-POS-AUX: J12.14, R51.2, U12.3, U14.7 (GPIO9)
GND: C1.2, C2.1, C3.1, C4.1, C5.1, C6.1, C7.1, C8.1, C9.1, C10.2, C11.2, C12.1, C13.1, C14.2, C15.1, C17.1, C18.1, C22.1, C23.1, C26.1, C27.2, C29.1, C30.1, C31.2, C32.1, C33.1, C34.1, C35.1, C36.1, C37.1, C38.2, C39.2, C40.2, C43.2, C44.2, C45.2, C46.2, C47.2, C48.1, C49.1, C50.2, C51.2, C52.2, C53.2, C56.2, C58.2, C59.2, C61.2, C63.2, C65.2, C66.1, C67.1, C68.2, C69.1, C70.2, C71.2, C72.2, C73.1, C74.1, C75.2, C82.2, C83.2, C84.2, C85.2, C86.2, C87.2, C88.2, C89.2, C90.2, C91.1, C92.2, C93.2, C100.2, C101.2, C102.2, C104.1, D3.1 (A1), D6.1 (A1), D13.1 (K), D17.1 (K), D18.1 (A1), D21.1 (A1), D22.1 (K), D23.2 (A), D26.1 (A1), D30.1 (A1), D31.2 (A2), D34.1 (K), D39.1 (A1), D40.1 (A1), D46.1 (K), D48.1 (K), D49.1 (K), GND1.1 (1_1), J1.1, J1.2, J2.1 (Pin_1_1), J3.4, J5.3, J5.6, J5.15, J5.18, J5.SH, J6.3, J6.4, J6.30, J7.3, J7.4, J8.2, J9.A1 (GND), J9.A12 (GND), J9.B1 (GND), J9.B12 (GND), J9.SH (SHIELD), J11.A1 (GND), J11.A12 (GND), J11.B1 (GND), J11.B12 (GND), J11.SH (SHIELD), J12.11, J12.13, J12.15, J12.17, J12.19, J16.2, J19.A1 (GND), J19.A12 (GND), J19.B1 (GND), J19.B12 (GND), J19.SH (SHIELD), J22.11, J22.13, J22.15, J22.17, J22.19, Q1.1 (S), Q1.2 (S), Q1.3 (S), Q2.1 (S), Q2.2 (S), Q2.3 (S), Q3.1 (S), Q3.2 (S), Q3.3 (S), Q4.1 (S), Q4.2 (S), Q4.3 (S), R5.1, R10.1, R13.1, R14.1, R19.2, R21.2, R25.2, R27.2, R34.1, R36.1, R42.2, R51.1, R52.1, R74.1, R76.2, R77.2, R79.1, R80.1, R81.2, R82.2, R83.2, R88.2, R138.1, R139.1, R144.2, R146.1, R153.2, R154.2, SW1.1, SW2.1, SW3.1, SW4.1, TP3.1 (1_1), TP4.1, TP9.1, TP11.1 (1_1), TP16.1 (1_1), TP19.1 (1_1), TP23.1, TP24.1, TP38.1 (1_1), TP43.1, TP44.1, U1.3 (GND), U3.6 (GND), U3.9 (PowerPAD), U4.2 (-Vin), U5.4 (GND1), U8.2, U9.2, U10.4 (GND1), U10.5 (GND2), U11.3 (GND), U14.62 (VREG_PGND), U14.81 (GND), U15.2 (-Vin), U16.4 (GND1), U18.1 (ADDR), U18.3 (GND), U19.3 (GND), U20.62 (VREG_PGND), U20.81 (GND), U21.2 (~RE), U21.5 (GND), U22.8 (GND), U22.12 (~G), U25.1 (GND), Y1.2, Y1.4, Y2.2, Y2.4
GND CAN: C21.1, C24.1, C25.2, C28.1, D28.1 (A1), D29.2 (A2), D33.1 (K), J4.19, J4.SH, JP6.2, JP11.2, JP12.2, JP17.2, JP18.2, JP23.2, JP24.2, JP29.2, JP37.2, R30.2, TP5.1 (1_1), U4.5 (-Vout), U5.5 (GND2)
GND Shunt NTC -: C54.1, C55.1, C60.1, C64.1, C116.1, D45.1 (K), J14.1, J14.3, J15.2, R73.2, TP17.1 (1_1), U15.5 (-Vout), U16.5 (GND2), U17.1 (A1), U17.2 (A0), U17.7 (GND), U26.1 (GND)
HMI Serial RX: R48.2, R130.1, U14.48 (GPIO39)
HMI Serial TX: R45.2, R49.2, R129.1, U14.47 (GPIO38)
I2C SCL Shunt: R57.2, TP15.2, U14.21 (GPIO21), U16.3 (SCL1)
I2C SCL Vsense: R90.2, TP25.2, U14.23 (GPIO23), U18.10 (SCL), U19.10 (SCL)
I2C SDA Shunt: R66.2, TP15.1, U14.25 (GPIO24), U16.2 (SDA1)
I2C SDA Vsense: R89.2, TP25.1, U14.22 (GPIO22), U18.9 (SDA), U19.9 (SDA)
IsoSPI RX Debug: TP24.2, U14.39 (GPIO31)
IsoSPI RX Debug 2: TP43.2, U20.39 (GPIO31)
IsoSPI RX H: TP35.1, U14.36 (GPIO28), U20.36 (GPIO28), U22.5 (2Y)
IsoSPI RX L: TP35.2, U14.37 (GPIO29), U20.37 (GPIO29), U22.3 (1Y)
IsoSPI TX Data: TP34.2, U14.28 (GPIO27), U21.4 (DI)
IsoSPI TX En: TP34.1, U14.27 (GPIO26), U21.3 (DE)
IsoSPI+: J20.1, J21.1, TR1.4 (TX+)
IsoSPI-: J20.2, J21.2, TR1.6 (TX-)
Link Negative: J17.13, J18.5, R124.2
Link Positive: J17.22, J18.2, R125.2
MAIN-SUP TX/RX: R131.1, TP36.1, U14.79 (GPIO2)
MAX RX: J12.8, R133.2, U14.3 (GPIO6), U22.13 (4Y)
unnamed: BT5.1 (+), K5.14
unnamed: BT5.2 (-), BT6.1 (+)
unnamed: BT6.2 (-), R6.1
unnamed: BT7.1 (+), F3.1
unnamed: BT7.2 (-), BT8.1 (+)
unnamed: BT8.2 (-), K6.14
unnamed: C19.1, J4.20, J4.21, JP37.1, U6.2
unnamed: C19.2, R22.1, U6.1
unnamed: C20.1, J4.14, J4.23, U7.2
unnamed: C20.2, R23.1, U7.1
unnamed: C40.1, R53.2, Y1.3
unnamed: C41.1, R46.2, U12.2
unnamed: C42.1, R47.2, U13.2
unnamed: C71.1, R92.2, Y2.3
unnamed: C94.1, TP37.2
unnamed: C95.1, TP37.1
unnamed: Cell1.1 (+), R58.1, R59.1
unnamed: Cell1.2 (-), Cell2.1 (+), R60.1, R61.1
unnamed: Cell2.2 (-), Cell3.1 (+), R62.1, R63.1
unnamed: Cell3.2 (-), R64.1, R65.1
unnamed: D1.1 (A1), D2.2 (A2)
unnamed: D2.1 (A1), D3.2 (A2)
unnamed: D4.1 (A1), D5.2 (A2)
unnamed: D5.1 (A1), D6.2 (A2)
unnamed: D7.1 (K), R1.1
unnamed: D8.2 (A), R2.2
unnamed: D9.1 (K), R3.1
unnamed: D10.2 (A), R4.2
unnamed: D13.2 (A), R151.1
unnamed: D14.2 (A), R11.2
unnamed: D17.2 (A), R15.2
unnamed: D19.2 (A), R16.2
unnamed: D22.2 (A), R152.1
unnamed: D24.1 (A1), D25.2 (A2)
unnamed: D25.1 (A1), D26.2 (A2)
unnamed: D27.2 (A), R28.2
unnamed: D32.2 (A), R29.2
unnamed: D33.2 (A), R33.2
unnamed: D34.2 (A), R35.2
unnamed: D35.2 (A), R39.2
unnamed: D36.2 (A), R40.2
unnamed: D41.1 (K), R45.1
unnamed: D42.2 (A), FB2.1
unnamed: D43.1 (K), R50.1
unnamed: D44.2 (A), J11.A4 (VBUS), J11.A9 (VBUS), J11.B4 (VBUS), J11.B9 (VBUS), R78.2, TP22.1 (1_1)
unnamed: D45.2 (A), R17.2
unnamed: D46.2 (A), R85.2
unnamed: D47.2 (A), J19.A4 (VBUS), J19.A9 (VBUS), J19.B4 (VBUS), J19.B9 (VBUS), R155.2, TP41.1 (1_1)
unnamed: D48.2 (A), R140.2
unnamed: D49.2 (A), R143.2
unnamed: F3.2, R6.4
unnamed: F4.1, K5.13, K8.14
unnamed: F4.2, K8.13, L7.1
unnamed: H5.1, K6.13, K7.14, TH1.1, TH2.1, TH3.1
unnamed: H6.1, K7.13, L7.2, TH4.2, TH5.2, TH6.2
unnamed: J4.13, R23.2, R44.2
unnamed: J4.15, U9.4
unnamed: J4.16, U8.3
unnamed: J4.17, U8.4
unnamed: J4.18, U9.3
unnamed: J4.22, R43.1
unnamed: J4.24, R44.1
unnamed: J6.1, JP30.2
unnamed: J6.2, JP31.2
unnamed: J6.5, JP32.2
unnamed: J6.6, JP33.2
unnamed: J6.15, JP34.2
unnamed: J6.29, JP35.1
unnamed: J11.A5 (CC1), R79.2
unnamed: J11.B5 (CC2), R80.2
unnamed: J19.A5 (CC1), R138.2
unnamed: J19.B5 (CC2), R139.2
unnamed: JP5.2, R32.1
unnamed: JP36.2, R31.2
unnamed: Q1.4 (G), R7.2
unnamed: Q2.4 (G), R12.2
unnamed: Q3.4 (G), R37.2
unnamed: Q4.4 (G), R38.2
unnamed: R8.2, U8.1
unnamed: R9.2, U9.1
unnamed: R55.2, SW1.2, TP12.1 (1_1)
unnamed: R58.2, R59.2
unnamed: R60.2, R61.2, R67.2
unnamed: R62.2, R63.2, R67.1
unnamed: R64.2, R65.2
unnamed: R94.2, SW3.2, TP26.1 (1_1)
unnamed: R95.2, SW4.2, TP30.1 (1_1)
unnamed: R102.2, R108.1
unnamed: R103.2, R109.1
unnamed: R104.2, R110.1
unnamed: R105.2, R111.1
unnamed: R106.2, R112.1
unnamed: R107.2, R113.1
unnamed: R108.2, R114.1
unnamed: R109.2, R115.1
unnamed: R110.2, R116.1
unnamed: R111.2, R117.1
unnamed: R112.2, R118.1
unnamed: R113.2, R119.1
unnamed: R114.2, R120.1
unnamed: R115.2, R121.1
unnamed: R116.2, R122.1
unnamed: R117.2, R123.1
unnamed: R118.2, R124.1
unnamed: R119.2, R125.1
unnamed: R145.1, R146.2
unnamed: TH1.2, TH4.1
unnamed: TH2.2, TH5.1
unnamed: TH3.2, TH6.1
unnamed: C104.2, TR1.2 (C_TD)
unnamed: R145.2, TR1.5 (C_TX)
unnamed: R10.2, R12.1, U1.7 (OUTA)
unnamed: R5.2, R7.1, U1.5 (OUTB)
unnamed: C16.2, U3.1 (BOOT)
unnamed: R26.2, R27.1, U3.4 (VSENSE)
unnamed: C12.2, L1.1, U4.1 (+Vin)
unnamed: C21.2, FB1.1, U4.7 (+Vout)
unnamed: FL1.1, U5.7 (CANH)
unnamed: FL1.4, U5.6 (CANL)
unnamed: FL2.1, U10.7 (CANH)
unnamed: FL2.4, U10.6 (CANL)
unnamed: R34.2, R37.1, U11.7 (OUTA)
unnamed: R36.2, R38.1, U11.5 (OUTB)
unnamed: C52.1, R68.1, U14.59 (ADC_AVDD)
unnamed: R56.1, U14.35 (RUN)
unnamed: R71.2, U14.66 (USB_DM)
unnamed: R70.2, U14.67 (USB_DP)
unnamed: C49.2, L5.1, U15.1 (+Vin)
unnamed: C55.2, FB3.1, U15.7 (+Vout)
unnamed: R72.2, U16.6 (SCL2), U17.5 (SCL)
unnamed: R69.2, U16.7 (SDA2), U17.4 (SDA)
unnamed: C76.2, R96.1, R102.1, TP31.1 (1_1), U18.4 (AIN0), U19.6 (AIN2)
unnamed: C77.1, R97.2, R103.1, TP29.1 (1_1), U18.5 (AIN1)
unnamed: C78.2, R98.1, R104.1, TP33.1 (1_1), U18.6 (AIN2), U19.5 (AIN1)
unnamed: C79.1, R99.1, R105.1, TP27.1 (1_1), U18.7 (AIN3)
unnamed: C80.2, R100.1, R106.1, TP32.1 (1_1), U19.4 (AIN0)
unnamed: C81.1, R101.1, R107.1, TP28.1 (1_1), U19.7 (AIN3)
unnamed: C87.1, R126.1, U20.59 (ADC_AVDD)
unnamed: R128.2, U20.66 (USB_DM)
unnamed: R127.2, U20.67 (USB_DP)
unnamed: R136.1, U21.6 (A)
unnamed: R137.1, U21.7 (B)
unnamed: C96.2, U22.2 (1A)
unnamed: C97.2, U22.1 (1B)
unnamed: C98.2, U22.6 (2A)
unnamed: C99.2, U22.7 (2B)
unnamed: C94.2, U22.14 (4A)
unnamed: C95.2, U22.15 (4B)
PCS Charge: JP34.1, U14.46 (GPIO37)
PCS DCDC: JP30.1, U14.42 (GPIO33)
PCS Enable: JP31.1, U14.45 (GPIO36)
PCS IPC CAN RX: JP32.1, U14.44 (GPIO35)
PCS IPC CAN TX: JP33.1, U14.43 (GPIO34)
SUP-MAIN TX/RX: R132.1, TP36.2, U14.78 (GPIO1)
SX Serial RX: D32.1 (K), J3.3, J12.12, R134.2, TP6.2, U14.6 (GPIO8)
SX Serial TX: D27.1 (K), J3.2, J12.10, TP6.1, U14.4 (GPIO7)
Shunt Midpoint: J14.8
Shunt NTC +: C64.2, J14.7, J15.1, R84.1, U17.8 (Vbus)
Shunt Passive +: J14.6
Shunt Sense +: C62.2, J14.5, J15.3, U17.10 (Vin+)
Shunt Sense -: C62.1, J14.4, J15.4, U17.9 (Vin-)
Shunt_3V3: C54.2, C60.2, C116.2, R17.1, R69.1, R72.1, R84.2, TP49.1 (1_1), U16.8 (VCC2), U17.6 (VS), U26.2 (VO)
Shunt_5V: FB3.2, R73.1, TP18.1 (1_1), U26.3 (VI)
Snooper Debug: TP23.2, U14.40 (GPIO32)
Snooper Debug 2: TP44.2, U20.40 (GPIO32)
VBUS Detect USB1: J12.2, R78.1, R153.1, U14.80 (GPIO3)
VBUS Detect USB2: J22.2, R154.1, R155.1, U20.80 (GPIO3)
VContactor Sense: C30.2, R24.1, R25.1, U14.54 (GPIO43_ADC3)
VSenHalf: 1/2V1.1 (1_1), C69.2, C76.1, C77.2, C78.1, C79.2, C80.1, C81.2, R87.2, R88.1, R96.2, R97.1, R98.2, R99.2, R100.2, R101.2
V_{Contactor}: C14.1, C17.2, D16.1 (K), D20.1 (K), D24.2 (A2), D37.1 (K), D38.1 (K), J6.33, J6.34, J6.35, J6.43, J10.1, J10.3, J10.5, J10.7, L2.1, R11.1, R16.1, R24.2, R39.1, R40.1, R152.2
V_{in}: C1.1, C4.2, C6.2, D15.1 (K), R18.2, U3.7 (VIN)
Vin Logic Sense: C23.2, R18.1, R19.1, U14.53 (GPIO42_ADC2)

Notes on the sheet:
all JLC basic components
Overall HV Battery System Diagram
3.3V 1A LDO Supply
GPIO3 - GPIO12 on NC header
external NC switch for estop, or jumper to disable.
Not tested as of now
I2C ADDR: 0x49
Aux Input 3-5V limited by resistor dissipation for higher input voltage use external series resistor
FC Negative Contactor
Would be cool if it alternates with main
BMB side xfmr center tap has no connection reference to ground to prevent ESD
Use 3v3 so no logic translation necessary.
TX must be on this pin
GND to battery chassis
unused inputs left floating - internal bias
3A max output - 3.3V draws from this rail
1.122V
1.52V
PTC max current ~10A Under 1S charge time expected
100k input impedance 0.14mA typical ADC usage
Gate driver has internal 200k pullup, 2x in parallel = 100k pullup must pull down to always start in off state.
DIY connector
MCU Identification
In tesla packs the shunt is at the mid point of the pack and always live!
second ADS1115: 0-1 linkneg - outpos 0-3 linkneg - linkpos <- link voltage 1-3 outpos - linkpos <- voltage across FC pos contactor 2-3 batpos - linkpos <- voltage across battery pos contactor
Supervisor MCU
5V powers exteral ESP32 LCD also
FC Positive Contactor
Cells to Positive Link Contactor
close to MCU
Aux contacts inside of the FC contactors used to check for welding with or without energizing
Extra GPIO
FC positive contactor not used (no 12V connection)
API TTL RS232 HMI Interface
Redundant connectors
jumper wire from existing 63A PCS or heat pump fuse
Galvanically Isolated Area
isoSPI Transceiver
Shunt Current Sense
Redundant connectors only one used at a time
3.77V
Gate drivers have weak 120k pulldown. Make sure theyre off by default
pyro is always live
Default jumpers work for Deye and many others Foxess has CANH/L backwards (and grounds in different places) Most use this BYD pinout
Inside Penthouse
13V-16V input
Data must be after En
all JLC basic components except: inductor, 680uf cap
1A max output
5V 3A DC-DC Supply
5V 1A max power for external HMI interface MCU/LCD typically an ESP32-P4 LCD Dev board
Inverter CAN Interface
= 124.7 mA
Cells to Negative Link Contactor
4.8V min input on USB for 3.3V out of LDO DC-DC output is 5.27V so enough headroom
I2C ADDR: 0x48
Main MCU
SX 2012-2021 Serial Interface
501:1 voltage divider 400v = 0.7984V
Not used for standard setup
Specified DC-DC is the smaller package 3kV footprint will fit the 3kV or 6kV version H0505S-1WR2 = 6kV F0505S-1WR3 = 3kV - DC-DC output is 5.55v nominal with 5.2V input
ADCB: AIN0=LINKNEG, AIN1=OUTPOS, AIN2=BATPOS, AIN3=LINKPOS
Aux Ret
shunt is always live
JLC basic components except: inductor, output cap
Batman internal resistance
PCS Iso GND
JLC basic components except: MOSFET, TVS, Gate driver
TPS5430 is 36V max rated intended for 10V-16V
MOSFET OPTIONS: Logic Level - fully on below 5V - >50A, >60V BSC0805LS 100V 61A JLCPCB Part # C534374 - best price 6/26/2026 BSC0702LS 60V 84A JLCPCB Part # C501503 BSC067N06LS3G 60V 50A JLCPCB Part # C24199
I2C ADDR: 0x40
Power Input
Inverter connected to FC port
PTC 440V 56Ω
Blink Blink
FC negative controls pre-charge bypass
BMB Connector
Cells Positive Always Live
Tesla BMB Balancing pseudo circuit example * Informational Only *
first ADS1115: 0-1 batpos - batneg <- battery voltage 0-3 batpos - outneg <- diagonal voltage 1-3 batneg - outneg <- voltage across neg contactors/precharge 2-3 outpos - outneg <- output voltage
Inter-BMS CAN Interface
E-Stop Disable
Used for Pre-Charge
L must be after H
3.3k : 1k = 5.206V = 1.21mA 4.7k : 1.5k = 5.044V = 0.813mA
Negatives
HV system diagram and the precharge PTC board are in ../Precharge (Precharge.kicad_sch). The isoSPI hat is in ../isoSPI-Hat (isoSPI-Hat.kicad_sch).
ENA enabled while NC
Output via Fast Charge Connection
High Voltage Sense
since all cells share balancing leads balancing only 1/2 time if every cell = 60mA average balancing leads add extra 10-100mv drops so real is less
Contactor Connectors
Positives
I2C pins cannot be re-assigned
Matching connector: WJ15EDGK-3.81-04P-14-00A
- need to energize one more contactor constantly - not as standard Pre-charge wiring
- No new always live HV wiring - FC HV connection easier to wire? (packs with bolts) - low amp fuse inside penthouse - re-use existing 63A fuse

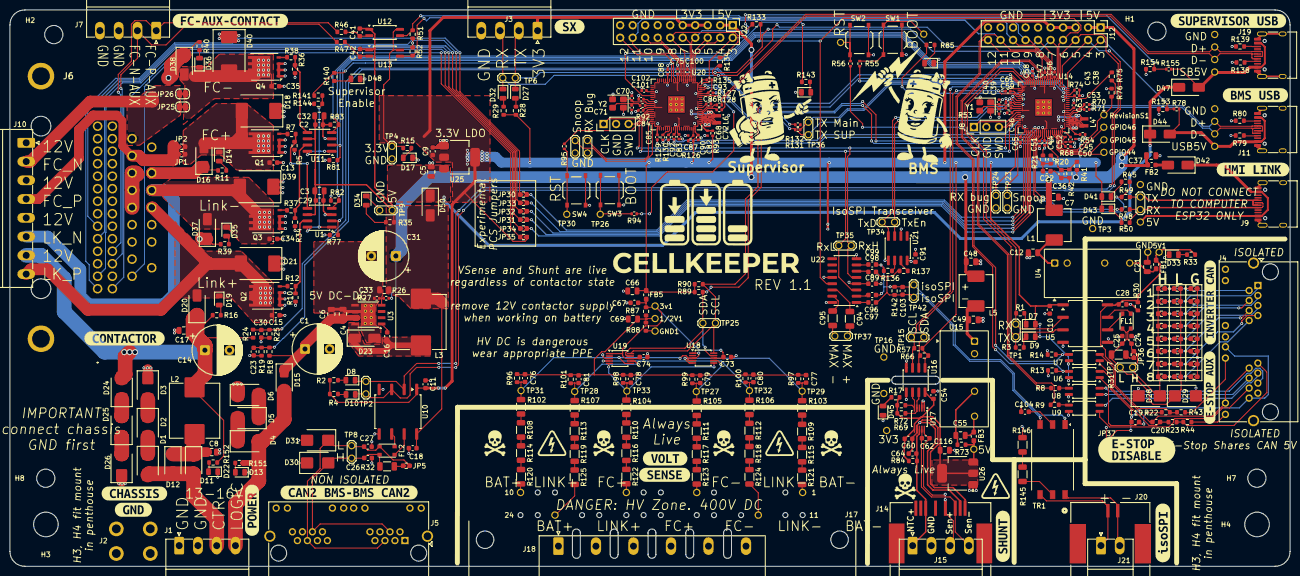
[picture p22: board CellKeeper.kicad_pcb from above]

Board: 4 copper layers, 260.0 x 113.0 mm, 474 parts (0 on the bottom side), 267 nets.

Other parts of the board:
ENC1: CellKeeper_Enclosure
kibuzzard-6A455E05: G***; kibuzzard-6A455E05
kibuzzard-6A455E28: G***; kibuzzard-6A455E28
kibuzzard-6A455E35: G***; kibuzzard-6A455E35
kibuzzard-6A455ED1: G***; kibuzzard-6A455ED1
kibuzzard-6A455F32: G***; kibuzzard-6A455F32
kibuzzard-6A455FAF: G***; kibuzzard-6A455FAF
kibuzzard-6A455FB8: G***; kibuzzard-6A455FB8
kibuzzard-6A4560A1: G***; kibuzzard-6A4560A1
kibuzzard-6A4560DE: G***; kibuzzard-6A4560DE
kibuzzard-6A4561AC: G***; kibuzzard-6A4561AC
kibuzzard-6A6094FF: G***; kibuzzard-6A6094FF
kibuzzard-6A45612B: G***; kibuzzard-6A45612B
kibuzzard-6A45614A: G***; kibuzzard-6A45614A
kibuzzard-6A456096: G***; kibuzzard-6A456096
kibuzzard-6A456143: G***; kibuzzard-6A456143
kibuzzard-6A456164: G***; kibuzzard-6A456164
kibuzzard-6AD6CA76: G***; kibuzzard-6AD6CA76
