clowrey/CellKeeper-BMS-PCB/(commit log)

2026-10-21 Add 3D-printable enclosure for the main board (build123d)
    enclosure/cellkeeper_case.py builds a base tray and lid around the board:
    - M3 screws from below self-tap into the lid pillars at H1/H2/H7/H8 (and
    H3/H4 while BOARD_SCREWS_AT_H3_H4 is set); 45 deg screw seats print
    without support
    - flat lid top 20 mm above the PCB with 4.3 mm bracket holes over H3/H4
    for the penthouse mounting brackets
    - connector openings, J6 passing through the lid, ground-screw slot,
    button guide tubes and LED light tunnels
    - lid markings as true curves: the silkscreen logo refit as lines and
    splines, KiBuzzard-style labels built from the KiBuzzard font
    - print files as STEP/STL (whole and split for 256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
    [CellKeeper.kicad_pcb, CellKeeper.kicad_sch, CellKeeper_board.step, base.step, base.stl, case_base.step, case_inlay.step, case_lid.step]
2026-10-21 README: v1.1, current board render and enclosure preview
2026-10-21 README: drop Getting Started; add update notes and image script
    - docs/readme-update.md: what changed in the README, how to refresh its
    images, and a review of the README against the Rev 1.1 schematic and
    board with suggested wording and open questions
    - python_scripts/render_readme_images.py renders the bare-board top view
    (ENC1 case footprint removed) and the right-front enclosure view
    - images re-rendered with the script
2026-10-21 README: 13-16 V logic and contactor inputs, 400 V nominal HV battery
2026-10-23 Enclosure: thread the bracket holes for the original bracket screw
    Model the penthouse bracket screw (measured from the original: PT-style
    thread-forming screw, 4.9 mm thread, 1.8 mm pitch, 30 deg flank, 19 mm
    long, 9.8 mm flange, hex-lobular head) and cut its thread into the two
    bracket holes above H3/H4, with the 3.0 mm core continuing to the 16 mm
    depth. The screws appear in the KiCad lid model with their heads 6 mm
    above the lid (the bracket tab), and as output/bracket_screw.step.
    [base.step, bracket_screw.step, case_base.step, case_inlay.step, case_lid.step, cellkeeper_case_assembly.step, lid.step, lid.stl]
2026-10-23 Enclosure: 0.4 mm clear LED windows instead of solid light pipes
    Solid clear rods down each LED tunnel spread the light too much. The
    light_windows part is now a 0.4 mm (two-layer) clear disc closing the top
    of each tunnel, with the tunnel below left hollow. New *_open print files
    leave the tunnels fully open. The KiCad lid model keeps the tunnels hollow.
    [base.step, bracket_screw.step, case_base.step, case_inlay.step, case_lid.step, cellkeeper_case_assembly.step, lid.step, lid_2color.step]
2026-10-24 Enclosure: underside map, open LED tunnels only, split files in a subfolder
    - The base underside carries the board's back-silkscreen map (UK + Ireland
    and Hawaii), refit as lines and splines and shown at twice its board size,
    centred: debossed (base) or as a 0.2 mm pocket plus inlay (base_2color).
    extract_logo.py now also copies the map; small specks and pinholes that
    can't print are dropped, and refits that cross themselves fall back to a
    tighter fit or the original outline.
    - The base splits at x = 266 (BASE_SPLIT_X), clear of the map.
    - LED tunnels are left open; the light-window and light-pipe versions are
    kept in enclosure/archive/light_windows.py.
    - Split pieces and keys ar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
    [base.step, base.stl, base_2color.step, base_2color.stl, base_2color_inlay.stl, bracket_screw.step, case_base.step, case_inlay.step]
